openUC2/UC2_microstepper_kinematicmount/KiCAD/PCB_Top_Rev4-PcbDoc.step

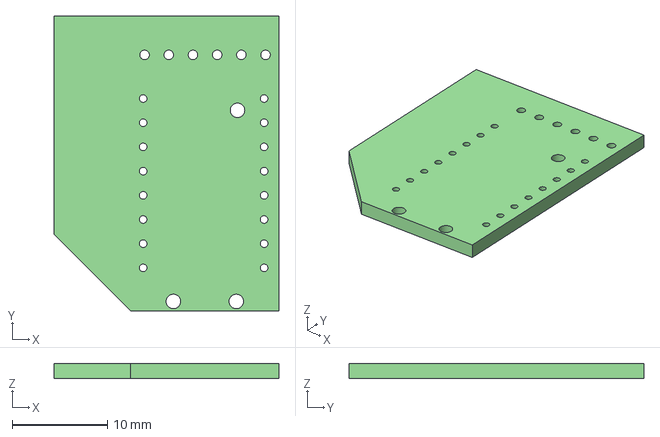
[picture p1: CAD file, 2023-02-04]
KiCAD/PCB_Top_Rev4-PcbDoc.step
23.6 x 30.9 x 1.60 mm
