openUC2/UC2_microstepper_kinematicmount/KiCAD/PCB_Top_Rev4-PcbDoc.kicad_sch

## KiCad design KiCAD/PCB_Top_Rev4-PcbDoc.kicad_sch (2023-02-04)

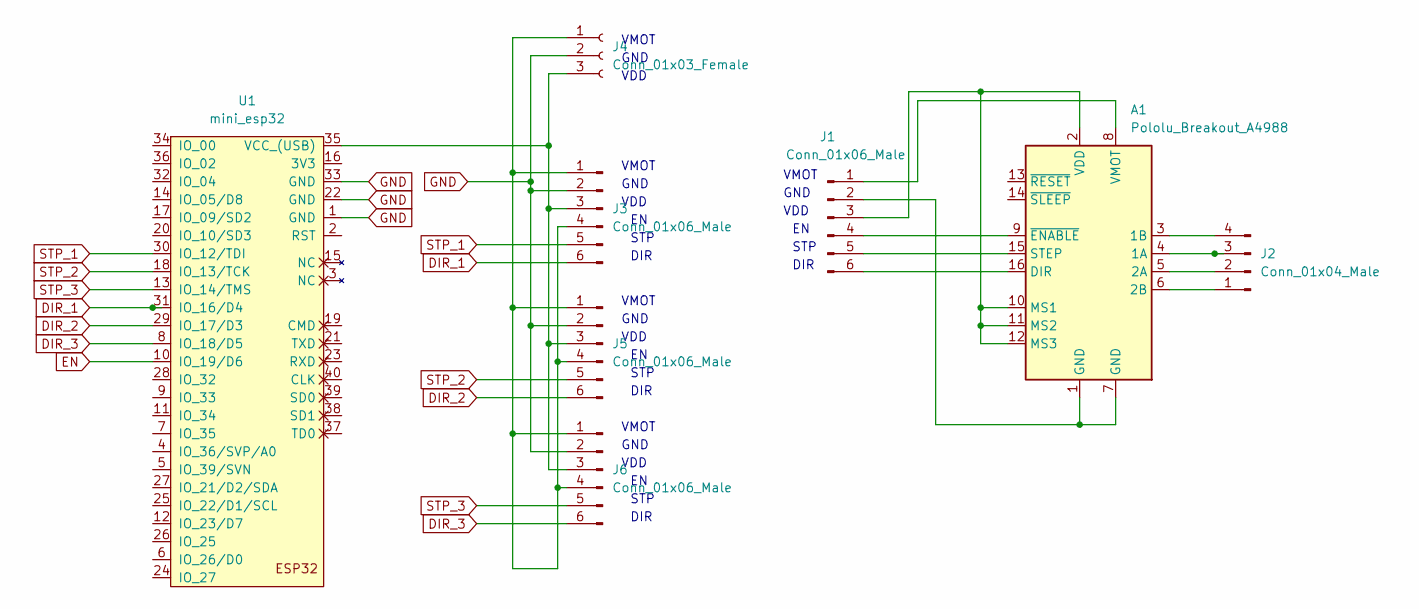
[picture p2: schematic PCB_Top_Rev4-PcbDoc.kicad_sch]

Parts:
A1: Pololu_Breakout_A4988; Pololu_Breakout-16_15.2x20.3mm
J1, J3, J5, J6: Conn_01x06_Male; PinHeader_1x06_P2.54mm_Horizontal
J2: Conn_01x04_Male; MicroLinearMotor
J4: Conn_01x03_Female; PinHeader_1x03_P2.54mm_Horizontal
U1: mini_esp32; ESP32_mini

Connections:
DIR_1: J3.6, U1.31 (IO_16/D4)
DIR_2: J5.6, U1.29 (IO_17/D3)
DIR_3: J6.6, U1.8 (IO_18/D5)
EN: U1.10 (IO_19/D6)
GND: J3.2, J4.2, J5.2, J6.2, U1.1 (GND), U1.22 (GND), U1.33 (GND)
unnamed: A1.1 (GND), A1.7 (GND), J1.2
unnamed: A1.3 (1B), J2.4
unnamed: A1.4 (1A), J2.3
unnamed: A1.5 (2A), J2.2
unnamed: A1.6 (2B), J2.1
unnamed: A1.8 (VMOT), J1.1
unnamed: A1.9 (~ENABLE), J1.4
unnamed: A1.2 (VDD), A1.10 (MS1), A1.11 (MS2), A1.12 (MS3), J1.3
unnamed: A1.15 (STEP), J1.5
unnamed: A1.16 (DIR), J1.6
unnamed: J3.1, J3.4, J4.1, J5.1, J5.4, J6.1, J6.4
unnamed: J3.3, J4.3, J5.3, J6.3, U1.35 (VCC_(USB))
STP_1: J3.5, U1.30 (IO_12/TDI)
STP_2: J5.5, U1.18 (IO_13/TCK)
STP_3: J6.5, U1.13 (IO_14/TMS)

Notes on the sheet:
GND
VMOT
STP
DIR
VDD
